cgxeiji/cgxkb/README.md

# cgxkb
Build guides and schematics of the CGx Keyboard series.

## Keyboards

- [The Space Between You and Me](./tsbym)
