cgxeiji/cgxkb/tsbym/sch/tsbym/custom3D/pmw3360.step

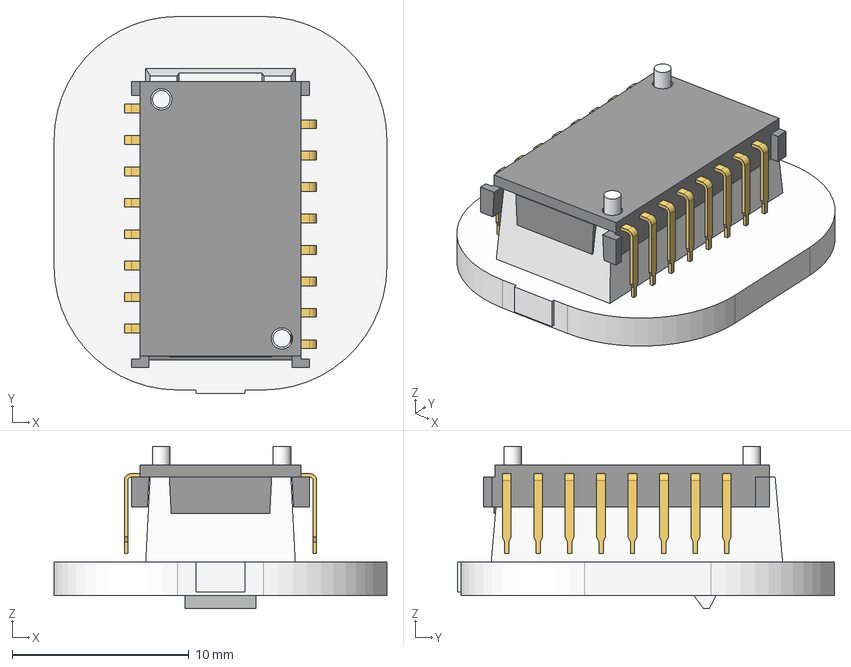
[picture p2: CAD file, 2021-11-14]
tsbym/sch/tsbym/custom3D/pmw3360.step
18.8 x 21.4 x 9.20 mm
pin1
chip
lense
