cgxeiji/cgxkb/tsbym/sch/tsbym/tsbym-top_plate/tsbym-top_plate.step

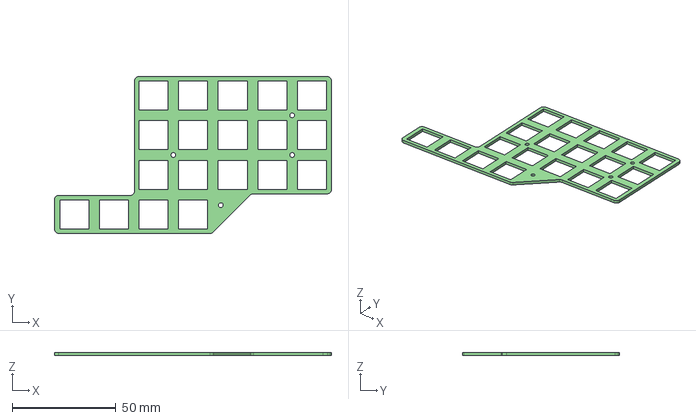
[picture p3: CAD file, 2021-11-14]
tsbym/sch/tsbym/tsbym-top_plate/tsbym-top_plate.step
133.2 x 75.4 x 1.60 mm
