cgxeiji/cgxkb/tsbym/sch/tsbym/custom3D/EC11E-nonSW.STEP

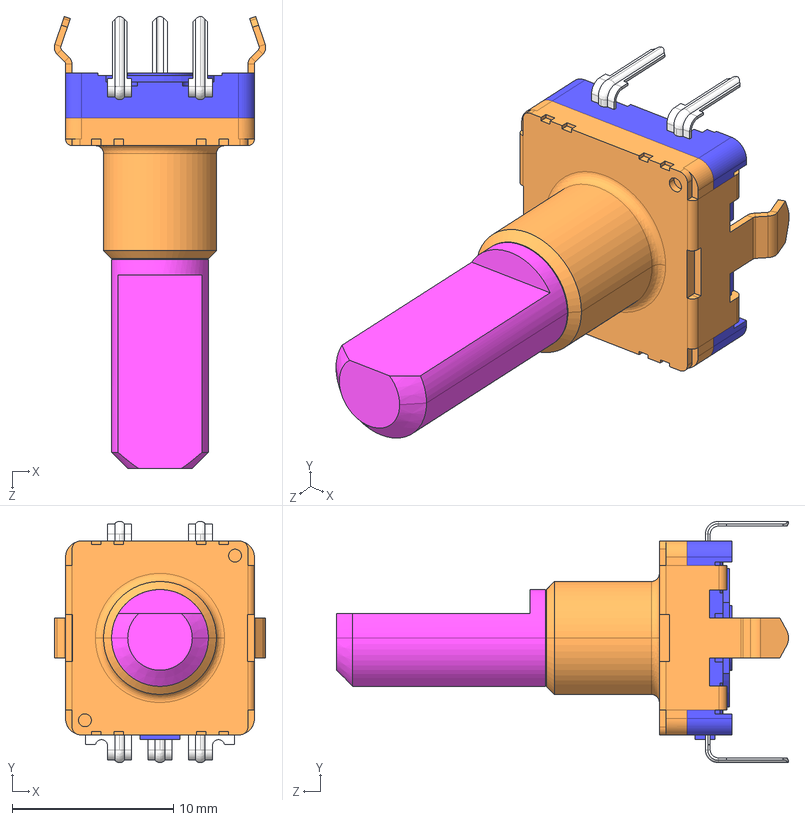
[picture p4: CAD file, 2021-11-14]
tsbym/sch/tsbym/custom3D/EC11E-nonSW.STEP
13.1 x 15.0 x 28.0 mm
