cgxeiji/cgxkb/tsbym/sch/tsbym/custom3D/1x4 pin male.step

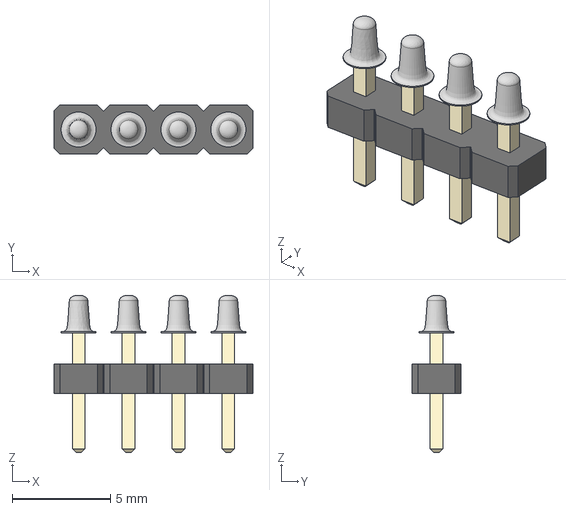
[picture p5: CAD file, 2021-11-14]
tsbym/sch/tsbym/custom3D/1x4 pin male.step
10.1 x 2.50 x 8.01 mm
