cgxeiji/cgxkb/(threads)

Thread 1 (2022-12-13):

BOM Table Missing

WMixter20, 2022-12-13:
Hi, I recently found this keyboard design and thought about making a version for me to use however when looking through the build guide I noticed that the BOM table was missing.

I copied what is there currently there below:
>Bill of Materials (BOM)
>First, let's make sure we have all the components necessary to build the keyboard.
>[insert table]

cgxeiji, 2022-12-17:
@WMixter20 Thank you so much for showing interest in this project!

This is a personal hobby of mine, so I apologize if development is slow. I was planning on releasing version 1.0.0 of the keyboard, but ran out of funds to finish development. I might have some time during the upcoming holidays to update the BOM so you can order the components from your local supplier. I hope you have the patience to wait for a little while.

Thank you!

cgxeiji, 2023-02-21:
Closed with [e6ada61](https://github.com/cgxeiji/cgxkb/commit/e6ada614ae1d6486f74c7c6fa3a175d93addb6b3).

Closed 2023-02-21.

Thread 3 (2024-06-25):

3D printing file

glompos21, 2024-06-25:
Hi Great work, Can i download from somewhere the 3d files for the case and trackball?

cgxeiji, 2024-08-27:
Thank you! I added the files [here](https://github.com/cgxeiji/cgxkb/tree/main/tsbym)!
