cgxeiji/cgxkb/tsbym/sch/tsbym/tsbym.pdf

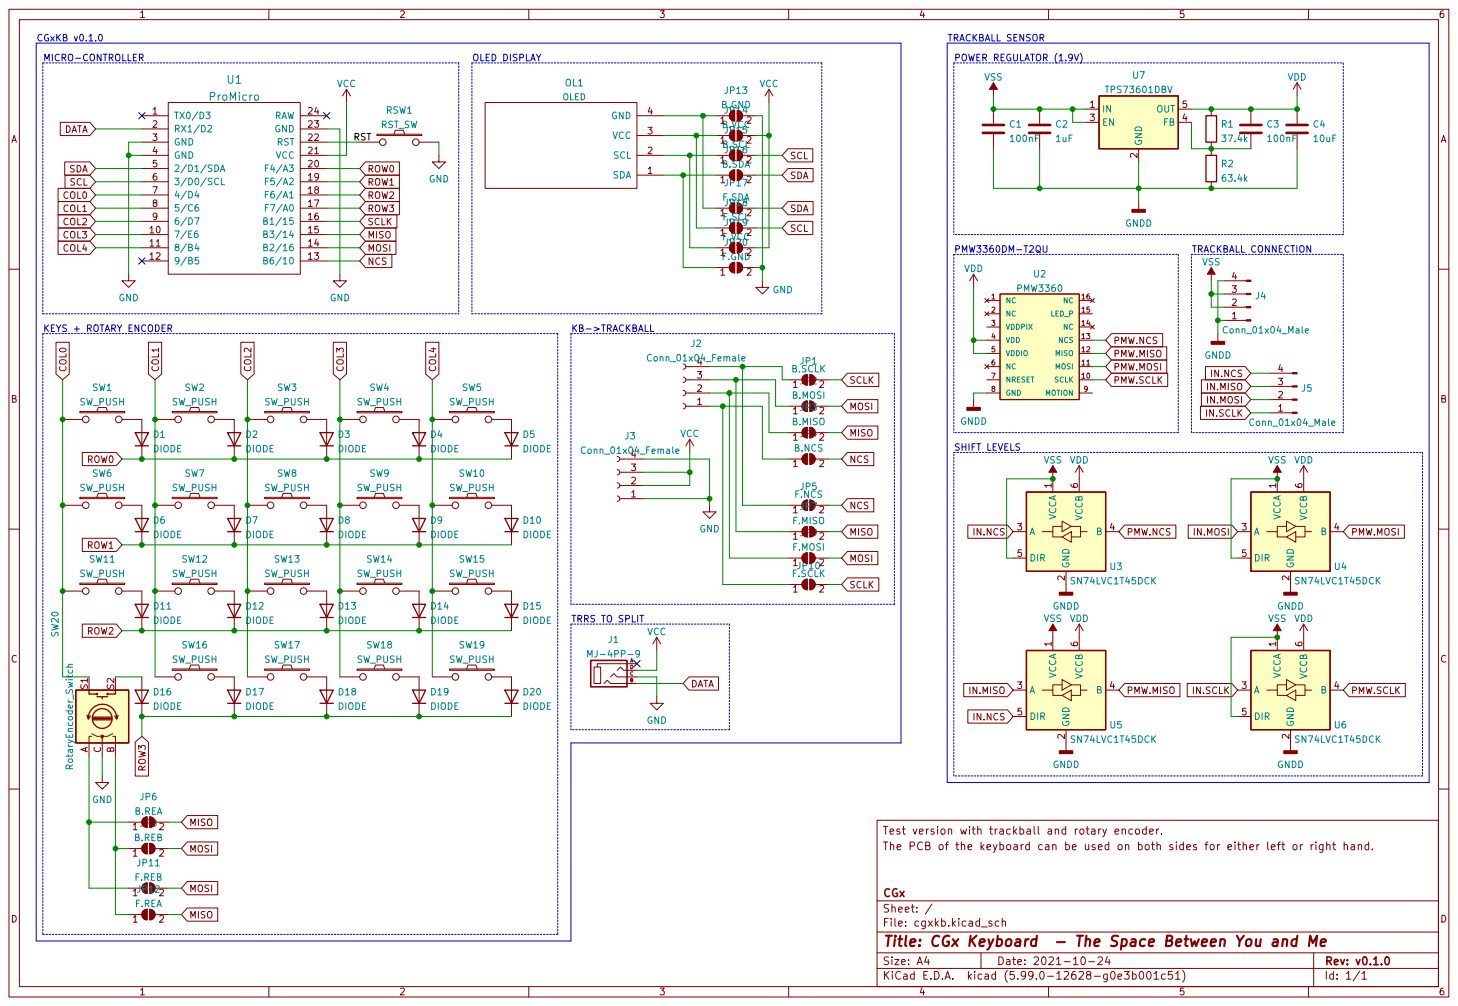
[picture p70: page 1]

KEYS + ROTARY ENCODER MICRO-CONTROLLER

ROW0
ROW3 SCLK MISO MOSI NCS

Test version with trackball and rotary encoder. GND

File: cgxkb.kicad_sch Sheet: / CGx The PCB of the keyboard can be used on both sides for either left or right hand.

Id: 1/1 Title: CGx Keyboard - The Space Between You and Me
