cgxeiji/cgxkb/tsbym/sch/tsbym/tsbym.kicad_pcb

## KiCad design tsbym/sch/tsbym/tsbym.kicad_pcb (2021-11-14)

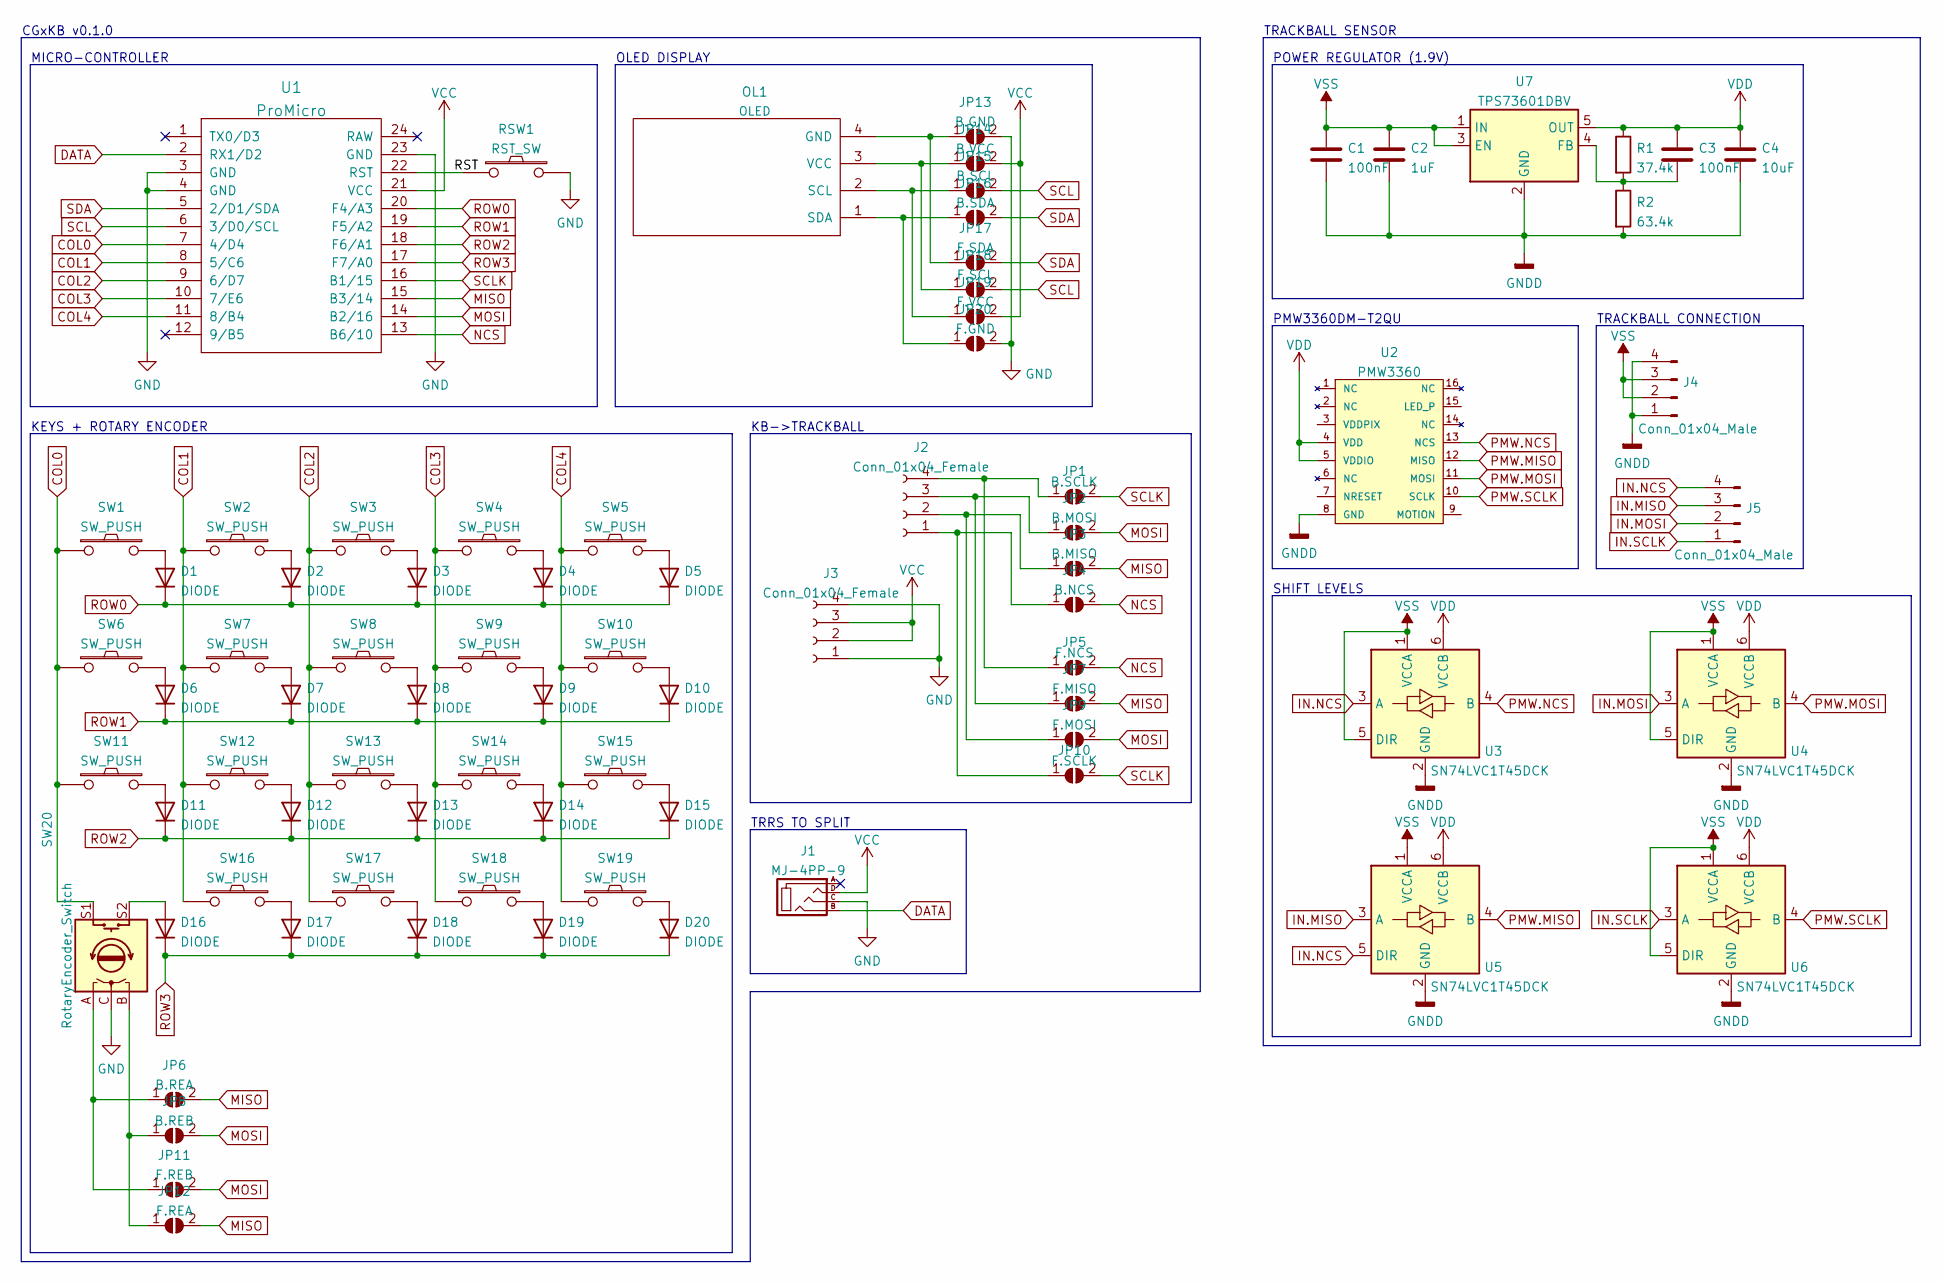
[picture p71: schematic tsbym.kicad_sch, CGx Keyboard - The Space Between You and Me]

Parts:
C1, C3: 100nF; C_0402_1005Metric_Pad0.74x0.62mm_HandSolder; LCSC C1525
C2: 1uF; C_0402_1005Metric_Pad0.74x0.62mm_HandSolder; LCSC C52923
C4: 10uF; C_0402_1005Metric_Pad0.74x0.62mm_HandSolder; LCSC C15525
D1, D2, D3, D4, D5, D6, D7, D8, D9, D10, D11, D12, D13, D14, D15, D16, D17, D18, D19, D20: DIODE; D3_TH_SMD
J1: MJ-4PP-9
J2, J3: Conn_01x04_Female; OLED
J4, J5: Conn_01x04_Male; OLED
JP1: B.SCLK; SolderJumper-2_P1.3mm_Open_RoundedPad1.0x1.5mm
JP2: B.MOSI; SolderJumper-2_P1.3mm_Open_RoundedPad1.0x1.5mm
JP3: B.MISO; SolderJumper-2_P1.3mm_Open_RoundedPad1.0x1.5mm
JP4: B.NCS; SolderJumper-2_P1.3mm_Open_RoundedPad1.0x1.5mm
JP5: F.NCS; SolderJumper-2_P1.3mm_Open_RoundedPad1.0x1.5mm
JP6: B.REA; SolderJumper-2_P1.3mm_Open_RoundedPad1.0x1.5mm
JP7: F.MISO; SolderJumper-2_P1.3mm_Open_RoundedPad1.0x1.5mm
JP8: B.REB; SolderJumper-2_P1.3mm_Open_RoundedPad1.0x1.5mm
JP9: F.MOSI; SolderJumper-2_P1.3mm_Open_RoundedPad1.0x1.5mm
JP10: F.SCLK; SolderJumper-2_P1.3mm_Open_RoundedPad1.0x1.5mm
JP11: F.REB; SolderJumper-2_P1.3mm_Open_RoundedPad1.0x1.5mm
JP12: F.REA; SolderJumper-2_P1.3mm_Open_RoundedPad1.0x1.5mm
JP13: B.GND; SolderJumper-2_P1.3mm_Open_RoundedPad1.0x1.5mm
JP14: B.VCC; SolderJumper-2_P1.3mm_Open_RoundedPad1.0x1.5mm
JP15: B.SCL; SolderJumper-2_P1.3mm_Open_RoundedPad1.0x1.5mm
JP16: B.SDA; SolderJumper-2_P1.3mm_Open_RoundedPad1.0x1.5mm
JP17: F.SDA; SolderJumper-2_P1.3mm_Open_RoundedPad1.0x1.5mm
JP18: F.SCL; SolderJumper-2_P1.3mm_Open_RoundedPad1.0x1.5mm
JP19: F.VCC; SolderJumper-2_P1.3mm_Open_RoundedPad1.0x1.5mm
JP20: F.GND; SolderJumper-2_P1.3mm_Open_RoundedPad1.0x1.5mm
OL1: OLED
R1: 37.4k; R_0402_1005Metric_Pad0.72x0.64mm_HandSolder; LCSC C25888
R2: 63.4k; R_0402_1005Metric_Pad0.72x0.64mm_HandSolder; LCSC C38606
RSW1: RST_SW; ResetSW
SW1, SW2, SW3, SW4, SW5, SW6, SW7, SW8, SW9, SW10, SW11, SW12, SW13, SW14, SW15, SW16, SW17, SW18, SW19: SW_PUSH; CherryMX_MidHeight_Choc_Hotswap
SW20: RotaryEncoder_Switch; RotaryEncoder_Alps_EC11E-Switch_Vertical_H20mm
U1: ProMicro; ProMicro_v2
U2: PMW3360; DIP-16_W10.16mm
U3, U4, U5, U6: SN74LVC1T45DCK; SOT-363_SC-70-6; LCSC C9382
U7: TPS73601DBV; SOT-23-5; LCSC C59200

Connections:
/RST: RSW1.1, U1.22 (RST)
COL0: SW1.1, SW6.1, SW11.1, SW20.S1, U1.7 (4/D4)
COL1: SW2.1, SW7.1, SW12.1, SW16.1, U1.8 (5/C6)
COL2: SW3.1, SW8.1, SW13.1, SW17.1, U1.9 (6/D7)
COL3: SW4.1, SW9.1, SW14.1, SW18.1, U1.10 (7/E6)
COL4: SW5.1, SW10.1, SW15.1, SW19.1, U1.11 (8/B4)
DATA: J1.B, U1.2 (RX1/D2)
GND: J1.C, J3.1, J3.4, JP13.2 (B), JP20.2 (B), RSW1.2, SW20.C, U1.3 (GND), U1.4 (GND), U1.23 (GND)
GNDD: C1.2, C2.2, C4.2, J4.1, J4.4, R2.2, U2.8 (GND), U3.2 (GND), U4.2 (GND), U5.2 (GND), U6.2 (GND), U7.2 (GND)
IN.MISO: J5.3, U5.3 (A)
IN.MOSI: J5.2, U4.3 (A)
IN.NCS: J5.4, U3.3 (A), U5.5 (DIR)
IN.SCLK: J5.1, U6.3 (A)
MISO: JP3.2 (B), JP6.2 (B), JP7.2 (B), JP12.2 (B), U1.15 (B3/14)
MOSI: JP2.2 (B), JP8.2 (B), JP9.2 (B), JP11.2 (B), U1.14 (B2/16)
NCS: JP4.2 (B), JP5.2 (B), U1.13 (B6/10)
unnamed: C3.2, R1.2, R2.1, U7.4 (FB)
unnamed: D1.1 (A), SW1.2
unnamed: D2.1 (A), SW2.2
unnamed: D3.1 (A), SW3.2
unnamed: D4.1 (A), SW4.2
unnamed: D5.1 (A), SW5.2
unnamed: D6.1 (A), SW6.2
unnamed: D7.1 (A), SW7.2
unnamed: D8.1 (A), SW8.2
unnamed: D9.1 (A), SW9.2
unnamed: D10.1 (A), SW10.2
unnamed: D11.1 (A), SW11.2
unnamed: D12.1 (A), SW12.2
unnamed: D13.1 (A), SW13.2
unnamed: D14.1 (A), SW14.2
unnamed: D15.1 (A), SW15.2
unnamed: D16.1 (A), SW20.S2
unnamed: D17.1 (A), SW16.2
unnamed: D18.1 (A), SW17.2
unnamed: D19.1 (A), SW18.2
unnamed: D20.1 (A), SW19.2
unnamed: J2.1, JP4.1 (A), JP10.1 (A)
unnamed: J2.2, JP3.1 (A), JP9.1 (A)
unnamed: J2.3, JP2.1 (A), JP7.1 (A)
unnamed: J2.4, JP1.1 (A), JP5.1 (A)
unnamed: JP6.1 (A), JP11.1 (A), SW20.A
unnamed: JP8.1 (A), JP12.1 (A), SW20.B
unnamed: JP13.1 (A), JP17.1 (A), OL1.4 (GND)
unnamed: JP14.1 (A), JP18.1 (A), OL1.3 (VCC)
unnamed: JP15.1 (A), JP19.1 (A), OL1.2 (SCL)
unnamed: JP16.1 (A), JP20.1 (A), OL1.1 (SDA)
PWM.MISO: U2.12 (MISO), U5.4 (B)
PWM.MOSI: U2.11 (MOSI), U4.4 (B)
PWM.NCS: U2.13 (NCS), U3.4 (B)
PWM.SCLK: U2.10 (SCLK), U6.4 (B)
ROW0: D1.2 (K), D2.2 (K), D3.2 (K), D4.2 (K), D5.2 (K), U1.20 (F4/A3)
ROW1: D6.2 (K), D7.2 (K), D8.2 (K), D9.2 (K), D10.2 (K), U1.19 (F5/A2)
ROW2: D11.2 (K), D12.2 (K), D13.2 (K), D14.2 (K), D15.2 (K), U1.18 (F6/A1)
ROW3: D16.2 (K), D17.2 (K), D18.2 (K), D19.2 (K), D20.2 (K), U1.17 (F7/A0)
SCL: JP15.2 (B), JP18.2 (B), U1.6 (3/D0/SCL)
SCLK: JP1.2 (B), JP10.2 (B), U1.16 (B1/15)
SDA: JP16.2 (B), JP17.2 (B), U1.5 (2/D1/SDA)
VCC: J1.D, J3.2, J3.3, JP14.2 (B), JP19.2 (B), U1.21 (VCC)
VDD: C3.1, C4.1, R1.1, U2.4 (VDD), U2.5 (VDDIO), U3.6 (VCCB), U4.6 (VCCB), U5.6 (VCCB), U6.6 (VCCB), U7.5 (OUT)
VSS: C1.1, C2.1, J4.2, J4.3, U3.1 (VCCA), U3.5 (DIR), U4.1 (VCCA), U4.5 (DIR), U5.1 (VCCA), U6.1 (VCCA), U6.5 (DIR), U7.1 (IN), U7.3 (EN)

Notes on the sheet:
CGxKB v0.1.0
MICRO-CONTROLLER
KEYS + ROTARY ENCODER
OLED DISPLAY
KB->TRACKBALL
TRRS TO SPLIT
TRACKBALL SENSOR
POWER REGULATOR (1.9V)
PMW3360DM-T2QU
SHIFT LEVELS
TRACKBALL CONNECTION

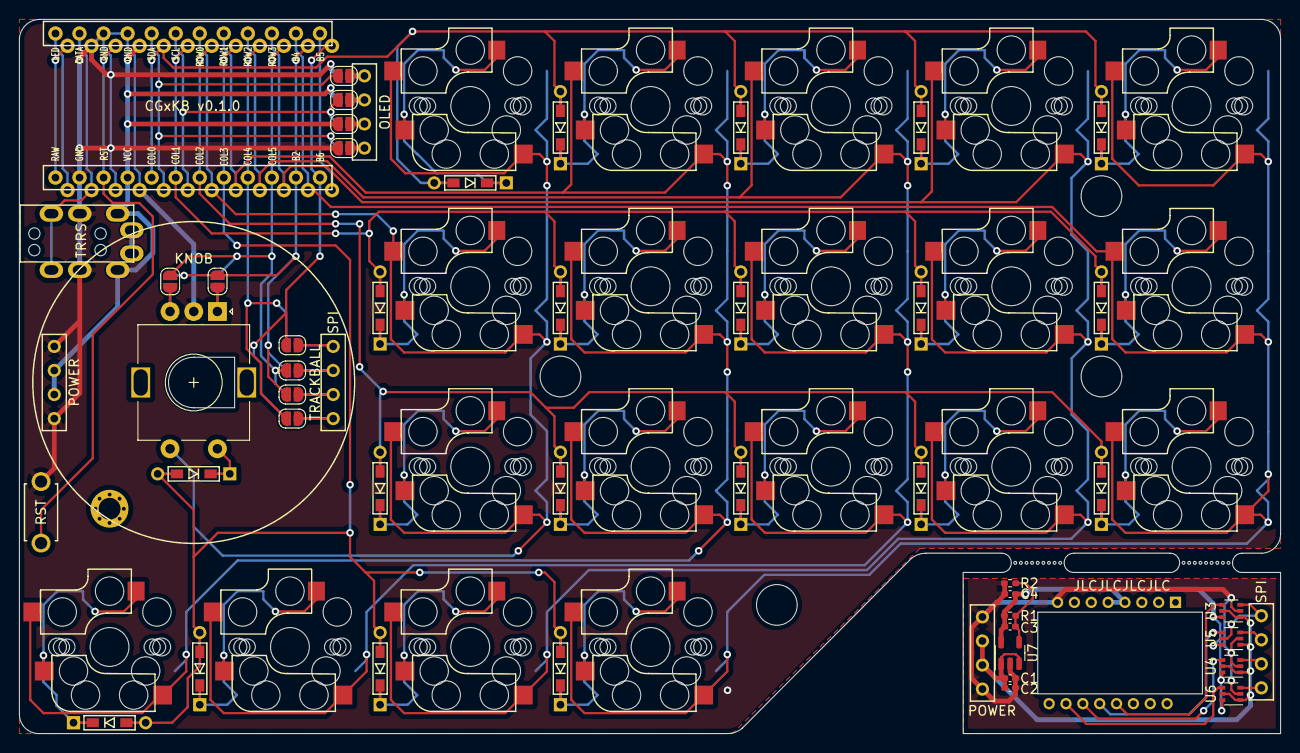
[picture p72: board tsbym.kicad_pcb from above]

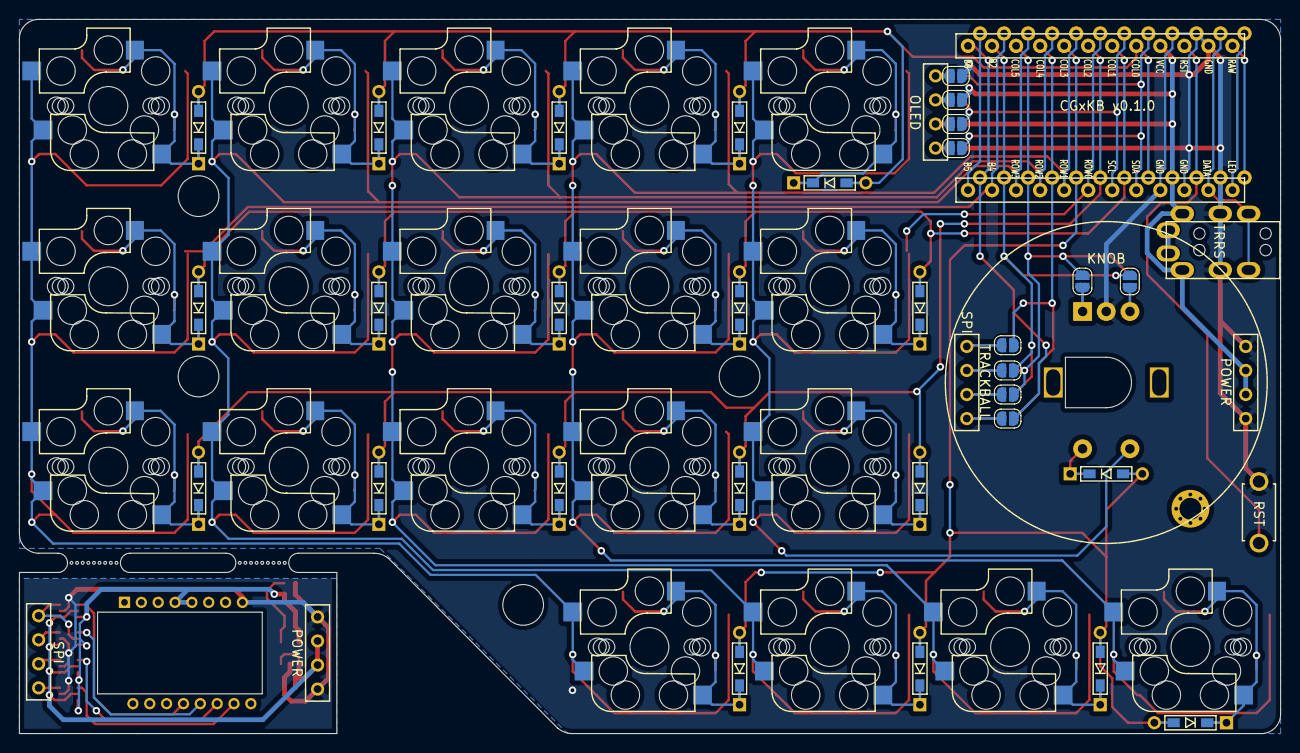
[picture p73: board tsbym.kicad_pcb from below]

Board: 2 copper layers, 133.2 x 75.4 mm, 85 parts (10 on the bottom side), 61 nets.

Other parts of the board:
Ref**: Val**; spacer_m2
Ref**#2: Val**; M2_HOLE_v3
Ref**#3, Ref**#4, Ref**#5: Val**; spacer_m2
