cgxeiji/cgxkb/(commit log)

2021-11-14 Added schematic
    [1x4 pin male.step, EC11E-nonSW.STEP, pmw3360.step, tsbym-top_plate.kicad_pcb, tsbym-top_plate.kicad_sch, tsbym-top_plate.step, tsbym.kicad_pcb, tsbym.kicad_sch]
2023-02-21 Added BOM.
